VictorManuel-Bautista/my-first-pcb/prj/my-first-pcb.kicad_pcb

## KiCad design prj/my-first-pcb.kicad_pcb (2026-02-03)

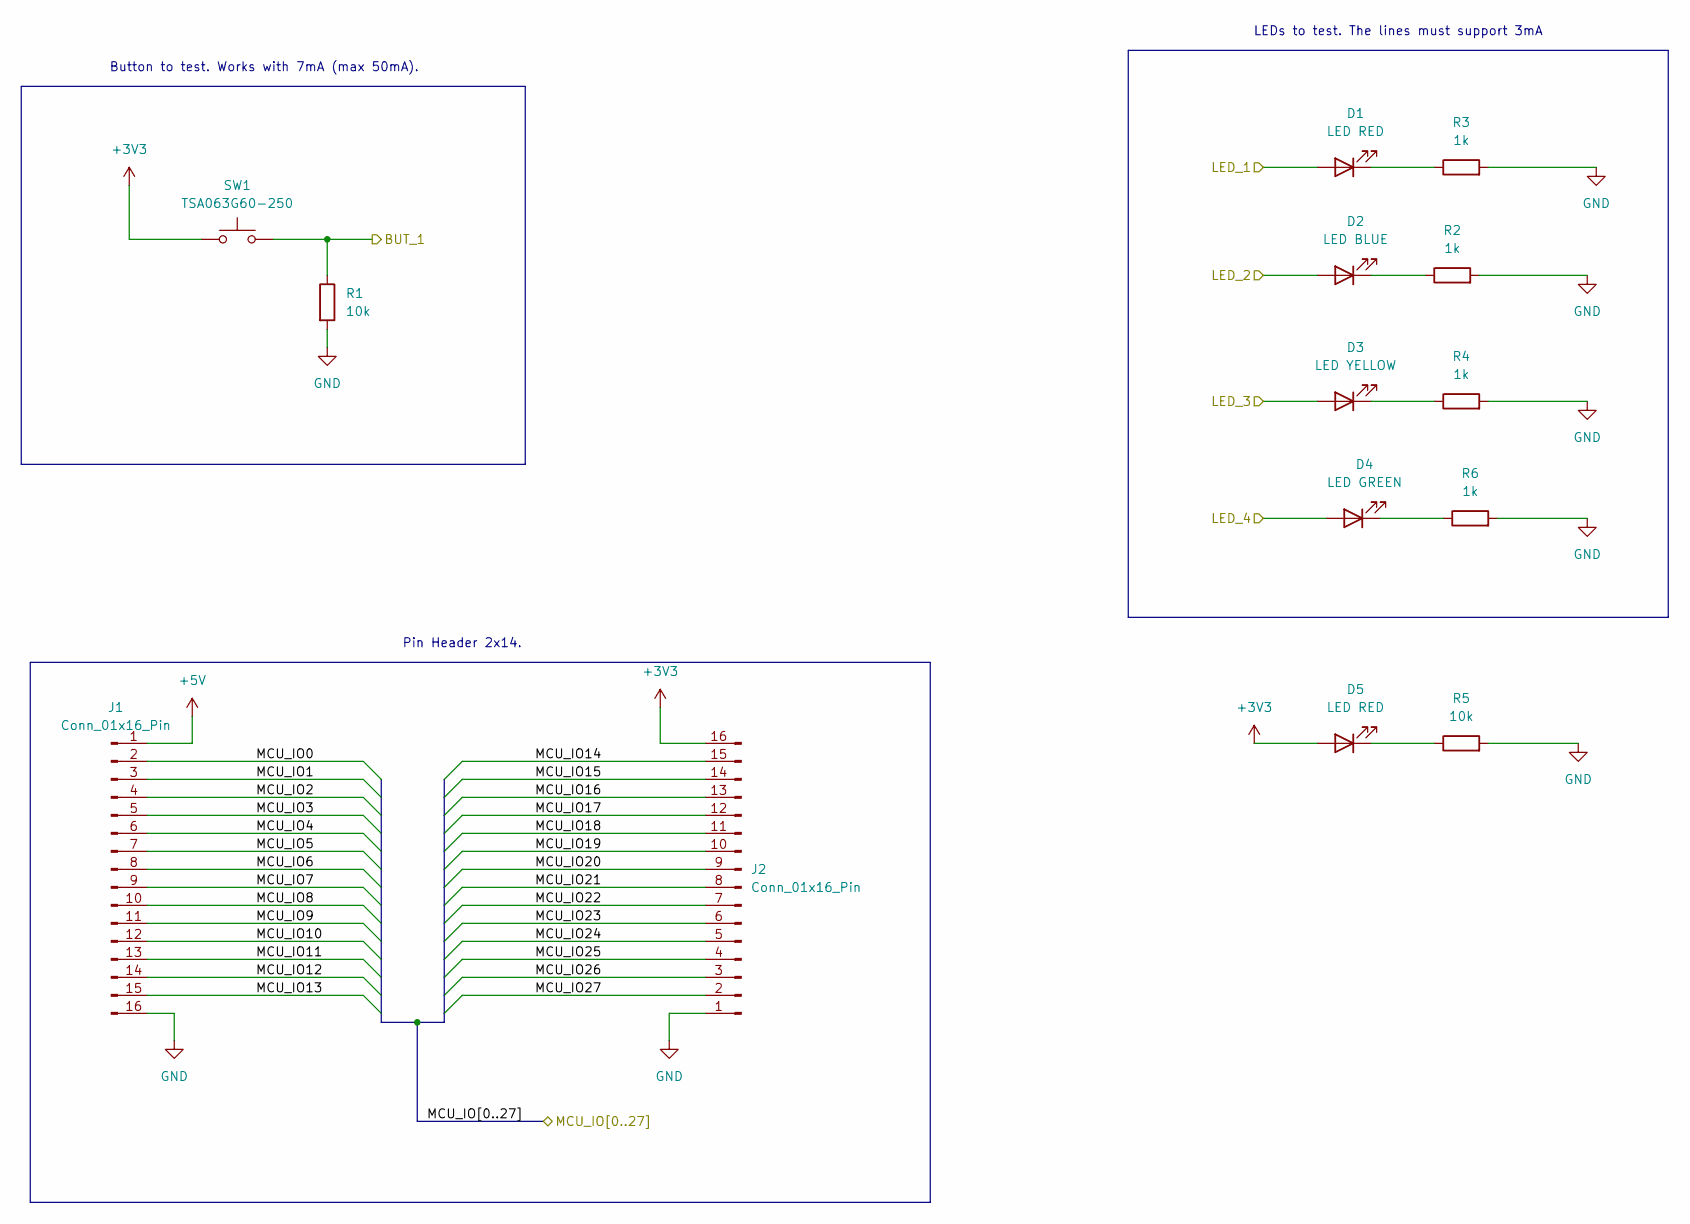
[picture p1: schematic Peripherals.kicad_sch]

Parts:
D1, D5: LED RED; LED_0603_1608Metric; LCSC C2286
D2: LED BLUE; LED_0603_1608Metric; LCSC C2288
D3: LED YELLOW; LED_0603_1608Metric; LCSC C2290
D4: LED GREEN; LED_0603_1608Metric; LCSC C2289
J1, J2: Conn_01x16_Pin; PinHeader_1x16_P2.54mm_Vertical
R1, R5: 10k; R_0603_1608Metric; LCSC C25804
R2, R3, R4, R6: 1k; R_0603_1608Metric; LCSC C21190
SW1: TSA063G60-250; SW_SPST_Omron_B3FS-105xP; LCSC C294566

Connections:
+3V3: D5.2 (A), J2.16, SW1.1; also elsewhere on the board
+5V: J1.1; also elsewhere on the board
/MCU/MCU_IO0: J1.2; also elsewhere on the board
/MCU/MCU_IO1: J1.3; also elsewhere on the board
/MCU/MCU_IO2: J1.4; also elsewhere on the board
/MCU/MCU_IO3: J1.5; also elsewhere on the board
/MCU/MCU_IO4: J1.6; also elsewhere on the board
/MCU/MCU_IO5: J1.7; also elsewhere on the board
/MCU/MCU_IO6: J1.8; also elsewhere on the board
/MCU/MCU_IO7: J1.9; also elsewhere on the board
/MCU/MCU_IO8: J1.10; also elsewhere on the board
/MCU/MCU_IO9: J1.11; also elsewhere on the board
/MCU/MCU_IO10: J1.12; also elsewhere on the board
/MCU/MCU_IO11: J1.13; also elsewhere on the board
/MCU/MCU_IO12: J1.14; also elsewhere on the board
/MCU/MCU_IO13: J1.15; also elsewhere on the board
/MCU/MCU_IO14: J2.15; also elsewhere on the board
/MCU/MCU_IO15: J2.14; also elsewhere on the board
/MCU/MCU_IO16: J2.13; also elsewhere on the board
/MCU/MCU_IO17: J2.12; also elsewhere on the board
/MCU/MCU_IO18: J2.11, R1.1, SW1.2; also elsewhere on the board
/MCU/MCU_IO19: D4.2 (A), J2.10; also elsewhere on the board
/MCU/MCU_IO20: D3.2 (A), J2.9; also elsewhere on the board
/MCU/MCU_IO21: D2.2 (A), J2.8; also elsewhere on the board
/MCU/MCU_IO22: D1.2 (A), J2.7; also elsewhere on the board
/MCU/MCU_IO23: J2.6; also elsewhere on the board
/MCU/MCU_IO24: J2.5; also elsewhere on the board
/MCU/MCU_IO25: J2.4; also elsewhere on the board
/MCU/MCU_IO26: J2.3; also elsewhere on the board
/MCU/MCU_IO27: J2.2; also elsewhere on the board
GND: J1.16, J2.1, R1.2, R2.2, R3.2, R4.2, R5.2, R6.2; also elsewhere on the board
unnamed: D1.1 (K), R3.1
unnamed: D2.1 (K), R2.1
unnamed: D3.1 (K), R4.1
unnamed: D4.1 (K), R6.1
unnamed: D5.1 (K), R5.1

Notes on the sheet:
Button to test. Works with 7mA (max 50mA).
LEDs to test. The lines must support 3mA
Pin Header 2x14.

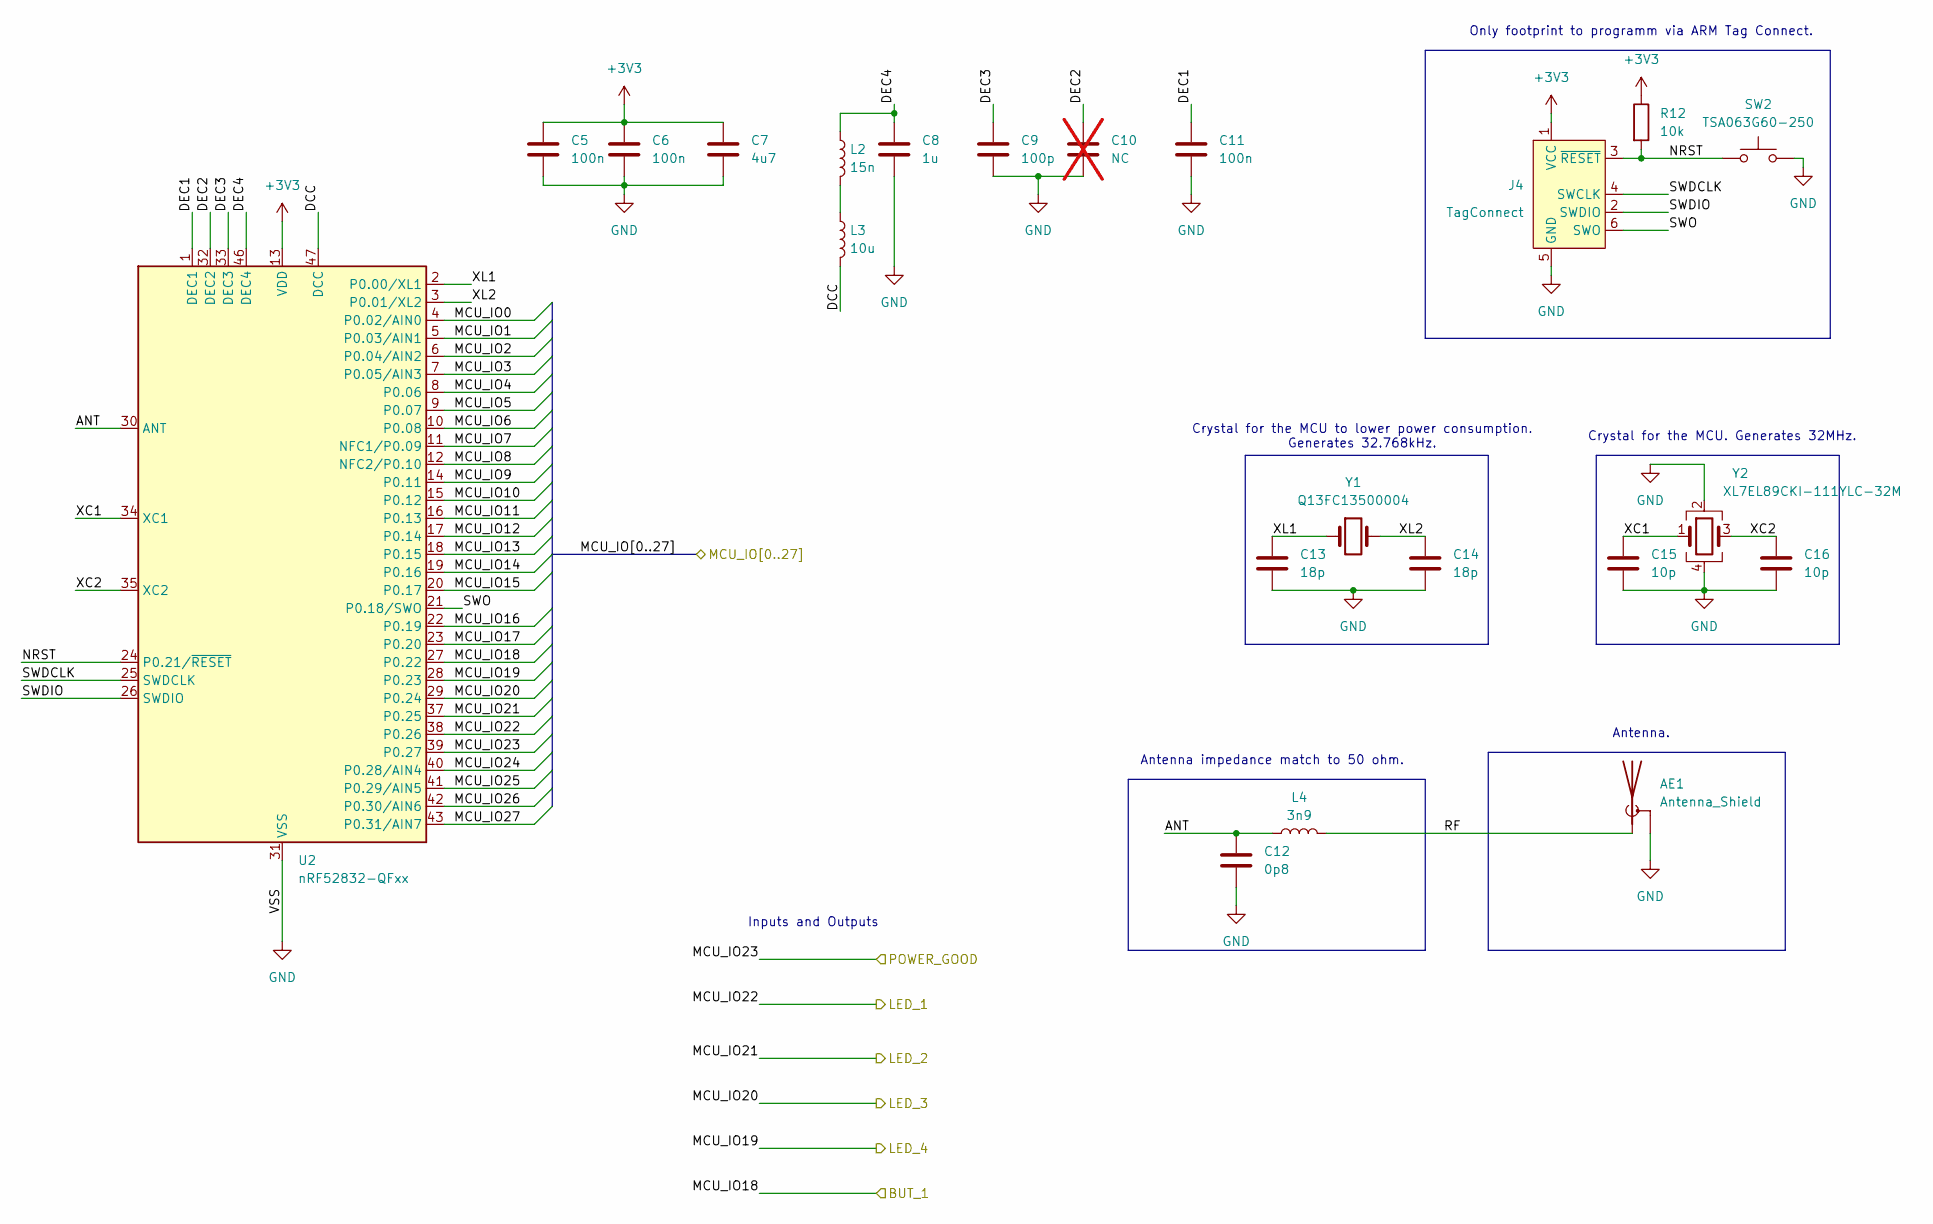
[picture p2: schematic MCU.kicad_sch]

Parts:
AE1: Antenna_Shield; Texas_SWRA117D_2.4GHz_Left
C5, C6, C11: 100n; C_0603_1608Metric; LCSC C14663
C7: 4u7; C_0603_1608Metric; LCSC C1705
C8: 1u; C_0603_1608Metric; LCSC C1592
C9: 100p; C_0603_1608Metric; LCSC C14858
C10: NC; C_0603_1608Metric; not fitted
C12: 0p8; C_0402_1005Metric; LCSC C40459
C13, C14: 18p; C_0603_1608Metric; LCSC C1647
C15, C16: 10p; C_0603_1608Metric; LCSC C1634
J4: TagConnect; Tag-Connect_TC2030-IDC-FP_2x03_P1.27mm_Vertical
L2: 15n; L_0603_1608Metric; LCSC C304267
L3: 10u; L_0805_2012Metric; LCSC C18221303
L4: 3n9; L_0402_1005Metric; LCSC C14033
R12: 10k; R_0603_1608Metric; LCSC C25804
SW2: TSA063G60-250; SW_SPST_Omron_B3FS-105xP; LCSC C294566
U2: nRF52832-QFxx; QFN-48-1EP_6x6mm_P0.4mm_EP4.6x4.6mm; LCSC C77540
Y1: Q13FC13500004; Crystal_SMD_3215-2Pin_3.2x1.5mm; LCSC C32346
Y2: XL7EL89CKI-111YLC-32M; Crystal_SMD_2016-4Pin_2.0x1.6mm; LCSC C2965582

Connections:
+3V3: C5.1, C6.1, C7.1, J4.1 (VCC), R12.1, U2.13 (VDD), U2.36 (VDD), U2.48 (VDD); also elsewhere on the board
/MCU/ANT: C12.1, L4.1, U2.30 (ANT)
/MCU/DCC: L3.2, U2.47 (DCC)
/MCU/DEC1: C11.1, U2.1 (DEC1)
/MCU/DEC2: C10.1, U2.32 (DEC2)
/MCU/DEC3: C9.1, U2.33 (DEC3)
/MCU/DEC4: C8.1, L2.1, U2.46 (DEC4)
/MCU/MCU_IO0: U2.4 (P0.02/AIN0); also elsewhere on the board
/MCU/MCU_IO1: U2.5 (P0.03/AIN1); also elsewhere on the board
/MCU/MCU_IO2: U2.6 (P0.04/AIN2); also elsewhere on the board
/MCU/MCU_IO3: U2.7 (P0.05/AIN3); also elsewhere on the board
/MCU/MCU_IO4: U2.8 (P0.06); also elsewhere on the board
/MCU/MCU_IO5: U2.9 (P0.07); also elsewhere on the board
/MCU/MCU_IO6: U2.10 (P0.08); also elsewhere on the board
/MCU/MCU_IO7: U2.11 (NFC1/P0.09); also elsewhere on the board
/MCU/MCU_IO8: U2.12 (NFC2/P0.10); also elsewhere on the board
/MCU/MCU_IO9: U2.14 (P0.11); also elsewhere on the board
/MCU/MCU_IO10: U2.15 (P0.12); also elsewhere on the board
/MCU/MCU_IO11: U2.16 (P0.13); also elsewhere on the board
/MCU/MCU_IO12: U2.17 (P0.14); also elsewhere on the board
/MCU/MCU_IO13: U2.18 (P0.15); also elsewhere on the board
/MCU/MCU_IO14: U2.19 (P0.16); also elsewhere on the board
/MCU/MCU_IO15: U2.20 (P0.17); also elsewhere on the board
/MCU/MCU_IO16: U2.22 (P0.19); also elsewhere on the board
/MCU/MCU_IO17: U2.23 (P0.20); also elsewhere on the board
/MCU/MCU_IO18: U2.27 (P0.22); also elsewhere on the board
/MCU/MCU_IO19: U2.28 (P0.23); also elsewhere on the board
/MCU/MCU_IO20: U2.29 (P0.24); also elsewhere on the board
/MCU/MCU_IO21: U2.37 (P0.25); also elsewhere on the board
/MCU/MCU_IO22: U2.38 (P0.26); also elsewhere on the board
/MCU/MCU_IO23: U2.39 (P0.27); also elsewhere on the board
/MCU/MCU_IO24: U2.40 (P0.28/AIN4); also elsewhere on the board
/MCU/MCU_IO25: U2.41 (P0.29/AIN5); also elsewhere on the board
/MCU/MCU_IO26: U2.42 (P0.30/AIN6); also elsewhere on the board
/MCU/MCU_IO27: U2.43 (P0.31/AIN7); also elsewhere on the board
/MCU/NRST: J4.3 (~RESET), R12.2, SW2.1, U2.24 (P0.21/~RESET)
/MCU/RF: AE1.1 (A), L4.2
/MCU/SWDCLK: J4.4 (SWCLK), U2.25 (SWDCLK)
/MCU/SWDIO: J4.2 (SWDIO), U2.26 (SWDIO)
/MCU/SWO: J4.6 (SWO), U2.21 (P0.18/SWO)
/MCU/XC1: C15.1, U2.34 (XC1), Y2.1
/MCU/XC2: C16.1, U2.35 (XC2), Y2.3
/MCU/XL1: C13.1, U2.2 (P0.00/XL1), Y1.1
/MCU/XL2: C14.1, U2.3 (P0.01/XL2), Y1.2
GND: AE1.2 (Shield), C5.2, C6.2, C7.2, C8.2, C9.2, C10.2, C11.2, C12.2, C13.2, C14.2, C15.2, C16.2, J4.5 (GND), SW2.2, U2.31 (VSS), U2.45 (VSS), U2.49 (VSS), Y2.2, Y2.4; also elsewhere on the board
unnamed: L2.2, L3.1

Notes on the sheet:
Antenna impedance match to 50 ohm.
Antenna.
Crystal for the MCU. Generates 32MHz.
Inputs and Outputs
Crystal for the MCU to lower power consumption. Generates 32.768kHz.
Only footprint to programm via ARM Tag Connect.

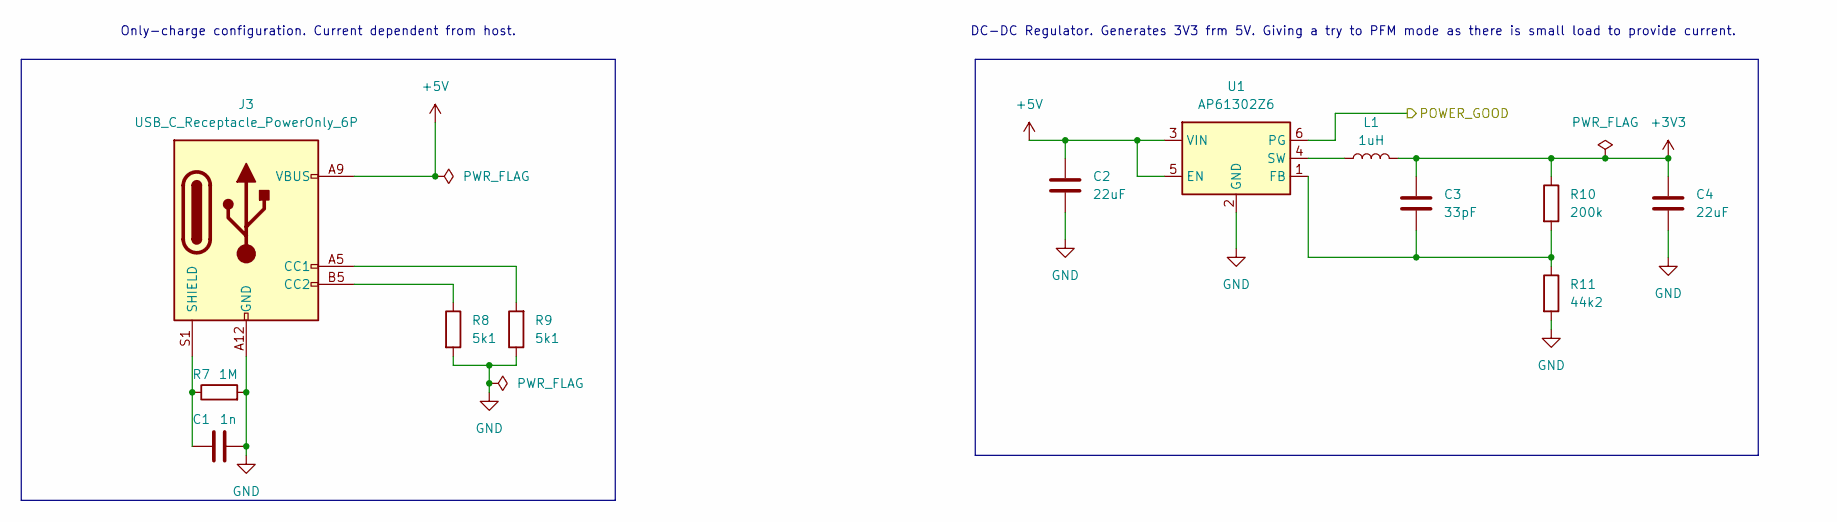
[picture p3: schematic Power.kicad_sch]

Parts:
C1: 1n; C_0603_1608Metric; LCSC C1588
C2, C4: 22uF; C_0603_1608Metric; LCSC C59461
C3: 33pF; C_0603_1608Metric; LCSC C1663
J3: USB_C_Receptacle_PowerOnly_6P; USB_C_Receptacle_GCT_USB4125-xx-x-0190_6P_TopMnt_Horizontal; LCSC C456012
L1: 1uH; L_Changjiang_FTC201610S; LCSC C2981230
R7: 1M; R_0603_1608Metric; LCSC C22935
R8, R9: 5k1; R_0603_1608Metric; LCSC C23186
R10: 200k; R_0603_1608Metric; LCSC C25811
R11: 44k2; R_0603_1608Metric; LCSC C23056
U1: AP61302Z6; SOT-563; LCSC C3193204

Connections:
+3V3: C3.1, C4.1, L1.2, R10.1; also elsewhere on the board
+5V: C2.1, J3.A9 (VBUS), J3.B9 (VBUS), U1.3 (VIN), U1.5 (EN); also elsewhere on the board
/MCU/MCU_IO23: U1.6 (PG); also elsewhere on the board
GND: C1.2, C2.2, C4.2, J3.A12 (GND), J3.B12 (GND), R7.2, R8.2, R9.1, R11.2, U1.2 (GND); also elsewhere on the board
unnamed: J3.A5 (CC1), R9.2
unnamed: J3.B5 (CC2), R8.1
unnamed: C1.1, J3.S1 (SHIELD), R7.1
unnamed: C3.2, R10.2, R11.1, U1.1 (FB)
unnamed: L1.1, U1.4 (SW)

Notes on the sheet:
Only-charge configuration. Current dependent from host.
DC-DC Regulator. Generates 3V3 frm 5V. Giving a try to PFM mode as there is small load to provide current.

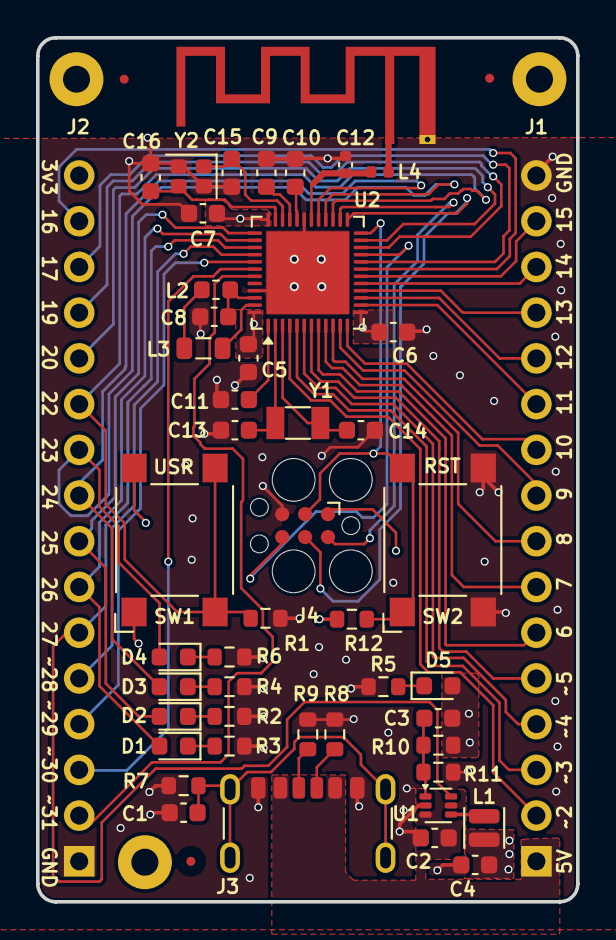
[picture p4: board my-first-pcb.kicad_pcb from above]

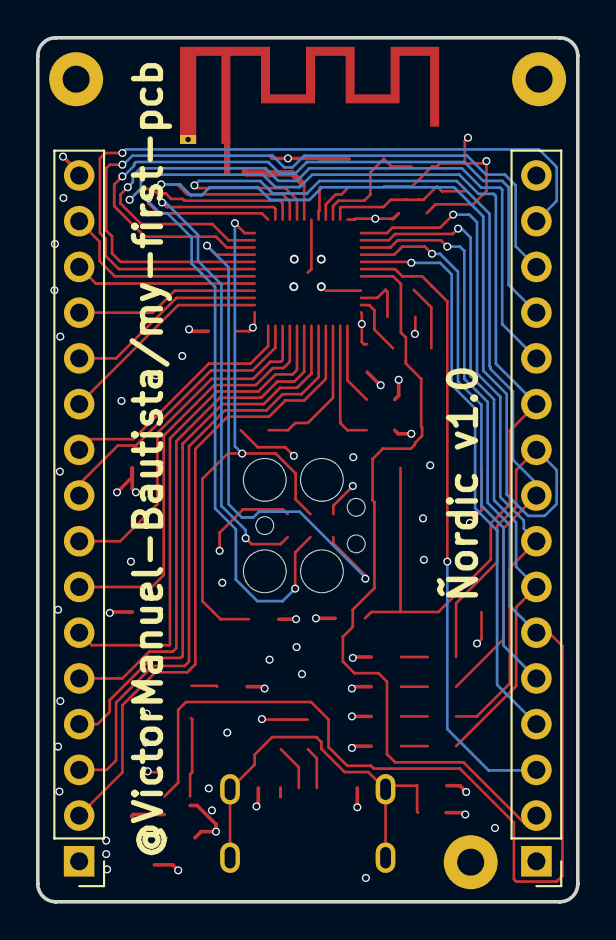
[picture p5: board my-first-pcb.kicad_pcb from below]

Board: 4 copper layers, 30.0 x 48.0 mm, 48 parts (2 on the bottom side), 57 nets.
