VictorManuel-Bautista/my-first-pcb/(commit log)

2025-12-29 pcb routing finished
    [MCU.kicad_sch, Peripherals.kicad_sch, Power.kicad_sch, my-first-pcb.kicad_pcb, my-first-pcb.kicad_sch]
2026-01-29 PCB routed trial 2
    [MCU.kicad_sch, Peripherals.kicad_sch, Power.kicad_sch, my-first-pcb.kicad_pcb]
2026-02-03 v1 ready
    [MCU.kicad_sch, my-first-pcb.kicad_pcb]
